Ajilaca/hd2026-T11-J5/docs/img/README.md

# docs/img

Gambar yang dipakai dokumen.

| Berkas | Isi |
|---|---|
| `arsitektur.png` | Diagram alur audio ke skor risiko, diturunkan dari `target/kv260/axi/rtl/suaratb_axil_top.sv`; dipakai di `README.md` |
