Ajilaca/hd2026-T11-J5/docs/vault/keputusan.md

# Keputusan Fase 0

Format: ID, keputusan, alasan, alternatif/risiko. Semua angka berasal dari `python -m golden.analysis.calibrate`
(hasil mentah: `golden/out/phase0_calibration.json`, di .gitignore) dan `pytest golden`.
**Seluruh kalibrasi memakai audio SINTETIS** (`golden/gen/synth.py`); dataset Kaggle belum ada di `data/raw`.

## K-01 Aritmetika
Pembulatan = tambah setengah lalu geser aritmetik (floor(v + 0,5)); saturasi eksplisit; int64 di numpy.
Alasan: cocok dengan penambah + pemotongan bit di RTL, tak memerlukan "round-to-even".

## K-02 Butterfly FFT
Satu pembulatan per butterfly: `(a·2^15 ± b·w + 2^(14+s)) >> (15+s)`. Twiddle k=0 = 32767 (1,0 tak terwakili di Q1.15).
Alasan: satu penambah lebar, galat lebih kecil daripada pembulatan ganda. Plateau SNR ~85 dB pada sinyal keras
dibatasi twiddle Q1.15, bukan lebar data (tabel di `kalibrasi-fase0.md`).

## K-03 Segmen 50 frame
Spesifikasi awal menyebut "segmen 40x50" dan "45 frame setelah onset". Ditafsirkan 5 frame pre-roll + 45 pasca-onset = 50.
50 frame membutuhkan 8240 sampel (0,515 s); klip dataset 8000 sampel diberi 240 nol di ekor.
Risiko: tafsiran ini asumsi; jika bukan itu maksudnya, ubah `PRE_ROLL`/`POST_ONSET`/`N_FRAMES` (CNN mengikuti).

## K-04 Lebar FFT = 24 bit, skala 1/2 di semua stage  *(mengubah nilai awal 18)*
Aturan yang ditetapkan: lebar terkecil dengan galat fitur log-mel ≤ 0,5 langkah int8 (0,0625 oktaf) pada
semua tingkat derau latar uji (σ = 1,5 sampai 100 LSB), dihitung pada elemen ≥ lantai derau kuantisasi
masukan + 10 dB, dengan jadwal skala yang dijamin tanpa overflow. Hasil (RMS galat, oktaf):

| W | σ=1,5 | σ=3 | σ=10 | σ=30 | σ=100 | SNR FFT σ=3 |
|---|---|---|---|---|---|---|
| 18 | 3,42 | 2,94 | 2,20 | 1,08 | 0,27 | -1,5 dB |
| 22 | 0,125 | 0,116 | 0,085 | 0,039 | 0,013 | 21,7 dB |
| 23 | 0,065 | 0,058 | 0,044 | 0,020 | 0,006 | 27,7 dB |
| **24** | **0,033** | **0,030** | 0,023 | 0,010 | 0,004 | **33,8 dB** |

18 bit gagal telak pada ruang tenang. 23 bit nyaris lolos (gagal di σ=1,5) dan lebar ganjil tak menguntungkan.
24 bit tetap muat satu blok DSP (data 24 bit pada port 25 bit, twiddle 16 bit pada port 18 bit).
Prinsip: derau pembulatan FFT (~0,58 LSB absolut) harus jauh di bawah derau kuantisasi int16 masukan;
pada G=8 selisihnya ~10 dB (menambah ~0,4 dB), pada G=2 (W=18) derau FFT justru lebih besar.
Alternatif yang dicatat: jadwal tanpa skala di 1-3 stage pertama menambah ~6 dB SNR per stage
(W=24: 34,3 -> 40,3 -> 46,3 -> 52,5 dB pada σ=3) tetapi kehilangan jaminan overflow: `first3_0` jenuh
(12 sampel) pada batuk ~-10 dBFS, `first1_0` tidak jenuh pada uji tetapi jaminannya hanya untuk puncak < -6 dBFS.
Dipilih jadwal aman. **Terbuka:** apakah pengguna mau `first1_0` (+6 dB) dengan jaminan lebih lemah.
Catatan: AUROC belum dapat diukur (tidak ada data berlabel), sehingga syarat "AUROC turun ≤ 0,01" BELUM diperiksa.

## K-05 Log2: masukan 58 bit, keluaran Q6.8 (spesifikasi awal: 32 bit, Q5.8)  *(mengubah spesifikasi)*
Dengan W=24 dan penguatan 2^(2G)=2^16, batas atas akumulator mel (Parseval, sinyal skala penuh) = 58 bit.
Memotongnya ke 32 bit memerlukan MEL_SHIFT yang bergantung data (13 bit pada ensemble sintetis) dan menyaturasi
bila gain mikrofon berubah. Leading-one 58 bit + keluaran 14 bit hanya menambah beberapa gerbang dan
menghilangkan satu konstanta yang bergantung data. MEL_SHIFT = 0 dipertahankan sebagai tuas bila nanti ingin dikecilkan.
Akurasi log2: ≤ 2 LSB Q.8 (0,008 oktaf) diuji `test_log2_accuracy`.

## K-06 Kuantisasi fitur ⚠
q = sat8(round((L - 6690) / 32)): langkah 0,125 oktaf (0,38 dB); rentang ±16 oktaf (±48 dB) di sekitar offset.
Ensemble sintetis: persentil 0,5/99,5 = 3380/9999 (L, Q6.8), 0,01% elemen nol. `FEAT_OFFSET` hanya berlaku
untuk gain mikrofon sintetis; HARUS dihitung ulang pada audio INMP441 nyata.

## K-07 Detektor batuk ⚠
Nilai awal 8 (rasio) dan 64 (EMA = 2^6), ≥ 2 frame dipertahankan. Sapuan K∈{4,6,8,12,16} x S∈{4..7} x min-hop∈{2,3}
pada aliran sintetis, aturan (ditetapkan sebelum melihat hasil): FP ≤ 0,5/menit (derau, klik, lompatan level;
nada keras dilaporkan terpisah), recall maksimum pada SNR 10 dB, lalu terdekat dengan nilai awal.
Hasil: **K=8, S=6, min-hop=2** (K=4/6 juga 100% pada 10 dB dan lebih tinggi pada 6 dB dengan FP sama, tetapi
lebih jauh dari nilai awal dan negatif sintetis tidak mewakili latar nyata; recall 100%
pada 10/15/25 dB, 61% pada 6 dB; FP derau 0, klik 0; lompatan level x4 memicu 1x per lompatan; nada keras 4,7/menit
tak dapat ditolak detektor energi, begitu pula bicara, dan diserahkan ke CNN).
Tafsiran "tahan 300 ms" = refractory 30 frame setelah segmen selesai. N dibekukan saat merekam; lantai N = 640 (derau ~2 LSB, asumsi).
Risiko: seluruh angka bergantung pada generator sintetis; tidak boleh dikutip sebagai kinerja detektor.

## K-08 Pre-emphasis tanpa pembulatan int16  *(menambah spesifikasi)*
Keluaran pre-emphasis 16+8 bit (bit pecahan = guard FFT). Diukur pada W=24, RMS galat fitur vs float
(6 klip batuk sintetis, 20 dB, elemen ≥ lantai derau masukan + 10 dB; oktaf):

| σ derau latar | pembulatan int16 | 16+8 bit |
|---|---|---|
| 1,5 | 0,066 | 0,029 |
| 3 | 0,064 | 0,027 |
| 10 | 0,120 | 0,024 |
| 30 | 0,044 | 0,011 |

Dengan int16 galat melewati ambang 0,0625 oktaf (K-04) pada σ ≥ 3; dengan 16+8 bit di bawahnya semua.
Biaya: window memakai operan 24 bit x 16 bit (1 DSP). Detektor memakai bagian bulat (pembulatan ke int16)
agar skalanya tak bergantung lebar FFT.

## K-09 CNN
Padding "same" nol; MaxPool lantai (25 -> 12, 12 -> 6): peta akhir 5x6, sesuai hitungan 3.698.448 MAC pada spesifikasi awal.
ReLU+saturasi [0,127] digabung dengan requant (aktivasi tersembunyi non-negatif). Logit akhir int16 (agar tidak
kehilangan resolusi untuk rata-rata 3-5 batuk). GAP lewat pengali resiprokal Q15. Bias int32 yang harus muat 24 bit.

## K-10 Akumulator 24 bit cukup
Fan-in terbesar 288 (conv3). |acc| ≤ 288·127·128 = 4.681.728 tanpa bias; batas 2^23 = 8.388.608; sisa untuk bias ≈ 3,7 juta.
Diuji analitik dan dengan masukan ekstrem (bobot semua -128). `AccOverflow` dilempar bila bias melanggar.

## K-11 Mel
HTK (2595·log10(1+f/700)), segitiga puncak 1 di domain Hz tiap bin, bobot Q0.12 (puncak dipotong 4095).
Tidak ada band kosong; tiap bin masuk ≤ 2 band; ROM sparse 493 kata x 19 bit {band, w, eob}.

## K-12 Anggaran
`budget.py` menghitung bit logis, blok per memori, pengali per fungsi (pemecahan operan DSP), dan siklus ideal.
Hasil P=16: 282 Kbit, 31 blok pengali, 231.168 siklus. EP4CE6 TIDAK muat konfigurasi dasar (memori 105%, pengali 41 vs 15).
Dengan kanal 8/16/16 memori muat (56%) tetapi pengali masih di atas 15 blok keras; perlu pengali di LUT.
Kapasitas perangkat dari ingatan, belum diverifikasi.

## Perubahan terhadap spesifikasi awal
| Item | Awal | Sekarang |
|---|---|---|
| Lebar FFT | 18 (24 bila SNR kurang) | 24 (K-04) |
| log2 | Q5.8, masukan 32 bit | Q6.8, masukan 58 bit (K-05) |
| Pre-emphasis | tak tentu | 16+8 bit (K-08) |
| Detektor 8 / 64 | tebakan | dipertahankan, berbasis sintetis (K-07) |

## K-13 Fase 2: antarmuka front-end (ditulis; tes unit lulus 2026-10-11, lihat K-19)
- `i2s_rx`: FPGA sebagai master (BCLK = clk/96, WS = BCLK/64). 24 bit MSB-first, tertunda 1 BCLK; keluaran = 16 bit teratas
  (pemotongan/lantai). Konsekuensi: derau kuantisasi masukan = int16 seperti diasumsikan golden; bit rendah mikrofon (24 bit)
  tidak dipakai (lihat butir terbuka di status-fase.md).
- `preemph`: SATU perkalian a·x[n-1] menghasilkan dua keluaran: `out_wide` (16+8 bit, jalur FFT, K-08) dan `out_s16`
  (int16, jalur detektor). Keduanya sama persis dengan golden `preemph(x, frac=8)` dan `preemph(x)`. Pembulatan ganda
  TIDAK diganti dengan pembulatan `out_wide` ke 16 bit karena hasilnya bisa berbeda 1 LSB.
- `frame_buf`: cincin 512 x 24 bit; frame diputar ulang 400 sampel/siklus-tunggal setelah sampel pemicu; energi hop
  dihitung di jendela [160f+240, 160f+400) = akhir frame f (golden `hop_energy`). Kontrak: jarak sampel >= 404 siklus.
- `cough_det`: antarmuka event (`trig`, `onset_frame`, `start_frame`, `end_frame`, `seg_done`); nilai pembekuan N saat merekam
  dan refractory identik golden. `seg_done` memberi tahu feat_buf (Fase 3) bahwa 50 kolom terakhir = segmen.

## K-14 FEAT_OFFSET dari audio nyata (6690 -> 8265)
Dihitung oleh `golden.analysis.calibrate_real` pada 1.764 klip batuk nyata (perekam). Dengan 6690 (sintetis) 2,0% elemen jenuh
int8, dengan 8265 0,2%. Model CNN Fase M dilatih pada fitur dengan offset ini, sehingga `params.py`, tabel, paket SV,
dan vektor ikut diubah. PROVISIONAL: gain mikrofon INMP441 berbeda; harus dihitung ulang pada audio perangkat.
FFT_W tetap 24 (pada data nyata W=22 juga lolos ambang K-04, 0,029 oktaf; belum diputuskan).

## K-15 Sumber data tambahan: TBscreen, bukan CODA (2026-10-11)
- CODA TB DREAM tidak dipakai: akses Synapse butuh akun Certified + Validated, Intended Data Use Statement (≤ 500 kata),
  dan persetujuan Terms of Use (Huddart dkk., Sci. Data 2024). Pengguna sudah mencoba; verifikasinya terlalu rumit untuk
  selesai sebelum Demo Day. Set latih "solicited" hanya 0,43 GB (1.105 peserta, 297 positif), jadi bila akses diperoleh
  kelak unduhannya cepat.
- Kriteria data tambahan: unduhan terbuka tanpa persetujuan, label TB per peserta, audio batuk WAV yang bisa di-resample
  ke 16 kHz, dan lisensi yang jelas.
- Terpilih: **TBscreen** (Sharma dkk., Sci. Adv. 2024; Nairobi; CC BY 4.0). Hanya WAV + CSV yang diambil (1,37 GB) dari
  zip 424,6 GB lewat HTTP range request. Klip 1 detik (batuk pasif dan paksa), tiga perangkat (Pixel, mik boundary, Yeti).
- Batas: populasi, perangkat, dan protokol berbeda dari Zambia. Makalah lintas-dataset (Zhang dkk., arXiv 2608.25846)
  melaporkan AUROC lintas-dataset sering < 0,6, jadi TBscreen dipakai untuk (a) evaluasi dalam-dataset kedua dan
  (b) uji lintas-dataset yang jujur, bukan untuk klaim generalisasi.
- Kandidat lain yang diperiksa: COUGHVID/Coswara (terbuka, tetapi COVID, tanpa label TB); halaman MakBRC Uganda
  sedang offline. Tidak ada dataset TB terbuka lain yang ditemukan.

## K-16 Hasil langkah 1-3: tidak ada sinyal audio-TB yang andal; distilasi dibatalkan (2026-10-11)
- TBscreen (`model.md` bagian 5): dalam-dataset 0,577 (nol p95 0,627); lintas-dataset 0,50-0,55; cohort A/C hampir = label
  (cohort saja 0,917), jadi angka dalam-TBscreen tidak dapat ditafsirkan sebagai penanda TB.
- Klinis diperluas (`model.md` bagian 4): 0,743 vs 0,730 (Δ +0,012, CI mencakup 0); fusi terbaik 0,768; target 0,80 belum tercapai.
- VGGish (`model.md` bagian 5): lebih buruk daripada log-mel di Zambia; distilasi tidak dilakukan.
- Dampak: target batuk-saja 0,70 dan fusi 0,80 tidak dicapai dan tidak diklaim. Klaim proyek tetap: pipeline lengkap dengan
  latensi/sumber daya terukur. Opsi revisi target (laporan CI + p-permutasi setelah kontrol sex/usia) menunggu keputusan pengguna.

## K-17 Arsitektur Fase 4: CNN output-stationary, paralel di kanal keluaran (2026-10-11)
- P lane = P kanal keluaran untuk piksel yang sama; 1 aktivasi/siklus dibroadcast; bobot P x 8 bit per
  siklus dari ROM; akumulator 24 bit; MaxPool pada akumulator sebelum requant (bit-exact dengan golden karena M0 >= 0 dan
  ReLU monoton); satu unit requant dipakai bergiliran; FC memakai pe_array yang sama (k=1); GAP unit kecil; padding lewat
  flag luar-batas; deskriptor layer dari ROM `.mem` sehingga model dapat diganti tanpa mengubah RTL.
- Alasan: 1 baca aktivasi/siklus (tanpa RAM berbank/line buffer), siklus = 231.168 pada P=16 (sesuai budget.py), risiko
  jadwal rendah. Ditolak: systolic/weight-stationary (kontrol rumit), paralel-piksel (butuh P aktivasi/siklus),
  akumulator + LR (bukan akselerator; hanya disebut sebagai alternatif hemat di proposal).
- Akurasi TIDAK diklaim (K-16); arsitektur dipilih demi demo akselerator yang terukur.

## K-18 Fase 3: antarmuka dan jadwal DSP (ditulis; tes unit lulus 2026-10-11, lihat K-19)
- Rantai: `frame_buf` -> `window` -> `fft512` -> `power` -> `mel` -> `log_q` -> `quant` -> `feat_buf` (`dsp_chain` membungkus
  window..quant). Semua parameter dari `suaratb_pkg`; ROM dari `rtl/mem/*.mem` (parameter `INIT_*`).
- Laju: waktu per frame tersedia 983 rb siklus (hop 160 sampel @ 98,304 MHz), kebutuhan ~6-8 rb siklus, jadi seluruh rantai
  dibuat SERIAL dan kecil: `fft512` 1 butterfly, 2 siklus/butterfly, RAM in-place 512 x 48 bit; jeda `DRAIN`=8 antar-stage
  (aman; urutan indeks sudah cukup, margin sengaja); keluaran bin tiap `OUT_GAP`=4 siklus (kontrak: `power` >= 1, `mel` >= 3).
- Perkiraan sumber daya (ESTIMASI, bukan laporan alat): pengali window 1, fft 4 (24x16), power 2 (24x24), mel 1 (48x12);
  RAM FFT 24 Kbit, RAM fitur 20 Kbit, akumulator mel 40 x 58 bit di register.
- Verifikasi tanpa simulasi RTL (aturan 3): model Python jadwal FFT (`golden/tests/test_fft_schedule.py`: bit-exact vs golden,
  waktu tulis a'/b', pengalamatan in-place, indeks twiddle, geser stage) dan model alamat window/mel/feat_buf
  (`golden/tests/test_dsp_addressing.py`). Testbench cocotb ditulis (`tb/dsp/test_{window,fft512,power,mel,log_q,quant,dsp_chain,
  feat_buf}.py`) dan baru dijalankan di Fase T. RTL belum di-lint.
  Pembaruan (K-19): tes unit modul dijalankan 2026-10-11 dan lulus; ini verifikasi per modul, bukan regresi terpadu.

## K-19 Aturan 3 diubah: tes unit per modul segera dijalankan (2026-10-11)
- Alasan: kode Fase 2-3 (~20 modul) belum pernah dijalankan; menunda ke Fase T menumpuk bug ke 17-19 Okt, dua hari sebelum
  Demo Day. Pengguna memilih menjalankan tes sekarang.
- Aturan baru: tiap modul Fase 1-5 ditulis bersama tb, lalu langsung dites sendiri (`make test-unit M=<modul>`) dan diperbaiki
  sampai hijau. Fase T tinggal integrasi dan regresi. Lint boleh kapan saja. Commit tetap ditunda sampai selesai dan
  dipecah per branch (fase1-2, fase3, fase4, fase5-6); Fase 5, T, 6 atas nama Faza Dzil.
- Simulator: Verilator 5.020 (apt) terlalu lama untuk cocotb 2.1 (`VerilatedVpi::clearEvalNeeded` tidak ada); tes unit memakai
  **Icarus 12** (`SIM=icarus`, default Makefile). `sva_stream.sv` (properti SVA) dilewati pada Icarus. Parameter string `.mem` dibuat
  tak bertipe (`parameter INIT_FILE = "..."`) karena Icarus 12 gagal mengikat `parameter string`; jalur `.mem` relatif terhadap ROOT.
- Hasil tes unit pertama (2026-10-11): quant, log_q, power, window, mel, fft512, feat_buf, dsp_chain, preemph, i2s_rx,
  frame_buf, cough_det semuanya LULUS bit-exact terhadap vektor golden. Dua perbaikan hanya di sisi tes (model mikrofon I2S tidak
  memulai slot kiri pertama; indeks di tes log_q/quant melebihi 6 bit). Lint Verilator: tanpa galat, hanya peringatan lebar/tak-terpakai.

## K-20 Fase 4: CNN output-stationary ditulis dan lulus tes unit (2026-10-11)
- Modul: `rtl/cnn/{cnn_cfg_pkg,pe_array,requant,gap,cnn_ctrl,cnn_top}.sv`. Bentuk layer/alamat ROM dari
  `golden/gen/gen_cnn_rom.py` (sumber tunggal `params.layer_descs()`, P dari params); ROM dikemas P lane (`cnn_wrom/bias/rq.mem`).
- Pool pada akumulator sebelum requant (bit-exact dengan golden); satu unit requant berurutan; GAP unit sendiri; FC memakai
  pe_array yang sama; deskriptor sebagai fungsi paket (bukan array parameter, kompatibel Icarus).
- HASIL SIMULASI (Icarus, bukan laporan alat): logit cnn_top == golden bit-exact untuk 5 kasus sintetis (bobot acak),
  8 klip dengan bobot terlatih model_v2, dan P = 8 / 16 / 32.
- Siklus inferensi terukur di simulasi (tanpa pemuatan 2.000 siklus): P=8: 451.851; P=16: 226.490; P=32: 122.843.
  Waktu @98,304 MHz = siklus x 10,17 ns -> P=16: ~2,30 ms (BERGANTUNG Fmax; Fmax belum diukur, Fase 6).
- Catatan: sebagian besar tidak dioptimalkan (tulis requant tidak tumpang-tindih dengan MAC), sumber daya belum diukur.

## K-21 Target akurasi diganti pelaporan terukur + pembanding WHO TPP (2026-10-11)
- Alasan: 0,70 (batuk saja) dan 0,80 (fusi) adalah tebakan awal pada spesifikasi awal, bukan syarat lomba atau standar medis. Hasil
  terukur: audio 0,52-0,63 (tidak beda dari nol permutasi); klinis 14 fitur 0,772 pada 1.828 peserta (205 positif); tambahan audio
  di atas klinis +0,003 (CI -0,021..+0,026) pada 360 peserta berlaudio; lintas-perangkat dan lintas-dataset 0,50-0,63.
- Standar pembanding: WHO TPP triase komunitas (sens >= 90%, spes >= 70%). Skor klinis kita: spes 38% pada sens 90%, sens 71% pada
  spes 70%; butuh AUROC ~0,90 (aproksimasi binormal). TIDAK dipenuhi dan tidak diklaim.
- Aturan baru: akurasi dilaporkan sebagai AUROC + CI 95% bootstrap atas peserta + nol permutasi + kontrol jenis kelamin/usia +
  hasil lintas-dataset/perangkat; setiap klaim melewati 0,5 harus menyebut apakah CI mencakup 0,5 atau nol permutasi.
  Target 0,70/0,80 dihapus sebagai syarat lulus. Penurunan kuantisasi <= 0,02 dan HW vs golden bit-exact tetap.
- Posisi alat: prioritas rujukan, bukan pengganti tes. Penguatan data (mis. CODA, K-15) = pasca-hackathon.

## K-22 Clock inti 147,456 MHz untuk versi 150 MHz (2026-10-11)
- Alasan: RTL `optimized` memenuhi timing 6,667 ns (150 MHz) di Vivado XC7A35T-1 untuk P = 8/16/32 (WNS +0,111 / +0,222 / +0,023 ns).
  Clock inti yang dipakai di `target/` = 147,456 MHz = 144 x 1,024 MHz, sehingga BCLK I2S = clk/144 = 1,024 MHz dan fs tepat 16 kHz.
- UART 115200 baud: CLK_PER_BIT = 147,456 MHz / 115200 = 1280 clk/bit (nilai pas). Menggantikan 98,304 MHz / 96 / 853 pada rencana awal.
- Default parameter `suaratb_top` (CLK_PER_BCLK=96, CLK_PER_BIT=853) belum diubah; nilai K-22 diberikan lewat parameter dari `target/`.
- Batas: baru hasil Vivado OOC (tanpa I/O dan MMCM); tidak ada klaim jalan di papan.

## K-23 Embedding pralatih: hasil, kriteria distilasi, dan distilasi dicoba (2026-10-12)
- Uji: HeAR, OPERA-CE, OPERA-CT + LR linear pada 364 peserta (60 positif) dengan protokol tetap (AUROC strat. jenis kelamin, nol
  permutasi dalam klinik x jenis kelamin, statistik maksimum atas tiga kandidat). Angka lengkap: `model.md` §5d.
- Kriteria distilasi ditetapkan sebelum angka final (docstring `model/evaluation/permtest.py`): (1) p label disesuaikan < 0,01; (2) p Δ < 0,05
  DAN batas bawah CI bootstrap Δ > 0; (3) leave-one-clinic-out tidak di bawah p95 nol di kedua arah.
- Hasil: (1) lolos untuk HeAR (0,002) dan OPERA-CT (0,006); (2) gagal untuk semuanya (p Δ 0,003-0,023 tetapi CI mencakup 0);
  (3) gagal (hasil berbeda antar arah). Kontrol negatif (fitur acak) bersih.
- Keputusan awal: menurut kriteria praregistrasi distilasi tidak dibenarkan sebagai klaim. **Distilasi tetap DICOBA sebagai percobaan
  eksploratori** (permintaan pengguna, untuk mengetahui apa yang terjadi), terpisah dari kriteria di atas dan tidak mengubah klaim.
- Hasil distilasi HeAR -> CNN golden (arsitektur hardware: Conv16/32/32, GAP, FC32->16, kepala pelatihan 16->32 komponen PCA; tanpa
  label TB pada distilasi; per lipatan protokol E0; probe LR di dalam lipatan; 364 peserta, 60 positif, 2 ulangan):
  murid 0,654 (nol p95 0,580, p 0,005) vs guru 0,672 pada klip yang sama; jaringan acak 0,598; target teracak 0,529; `model_v2`
  supervised ~0,56. Fidelitas komponen PCA rendah (R2 0,16). Δ di atas klinis +0,015 (tidak signifikan). Jalan pintas: murid
  memprediksi jenis kelamin 0,867 (guru 0,953) dan klinik Kan 0,655 (guru 0,896); AUROC dalam Kan 0,735.
- Keputusan model hardware: murid distilasi adalah KANDIDAT bobot eksploratori menggantikan `model_v2` (arsitektur sama, tanpa
  perubahan RTL). Kuantisasi int8 lulus (penurunan AUROC 0,008 <= 0,02) dan `cnn_top` bit-exact terhadap golden pada 8 klip nyata
  (`model.md` §5e). Bobot murid dapat dipakai pada demo dengan label "eksploratori"; `test_top` dengan bobot ini lulus (dataset dan mikrofon, Icarus); sintesis ulang belum dijalankan.
- Pengamatan boleh dilaporkan: sinyal audio di atas nol permutasi dalam jenis kelamin dengan HeAR/OPERA-CT, tambahan kecil di atas
  gejala klinis (Δ +0,02..+0,04), tahan lintas-mikrofon, tetapi belum presisi, belum konsisten lintas klinik, tanpa data independen.
- Batas: satu populasi, 364 peserta, tanpa data independen; tidak ada klaim klinis dari murid.
- Penguatan: lebih banyak peserta (CODA, K-15) dan validasi pada klinik/populasi lain, pasca-hackathon.

## K-24 Target KV260: clock inti 300,032 MHz (2026-10-18)
- Target demo: Kria KV260 (XCK26-SFVC784-2LV-C), kode di `target/kv260/` (RTL dan golden tidak berubah). K-22 (147,456 MHz) tetap berlaku untuk Artix-7.
- Clock inti dipilih 300,032 MHz = 293 x 1,024 MHz, sehingga `CLK_PER_BCLK = 293` (BCLK I2S 1,024 MHz tepat di nominal) dan `CLK_PER_BIT = 2604`.
- Dasar: pencarian Fmax build `full` (MMCM, I/O, XDC; Vivado 2026.1, satu seed). Pada 300,032 MHz P=16 WNS +0,065 ns dan P=32 +0,219 ns; pada 333,82 MHz P=16 gagal (-0,270 ns), P=32 lolos tipis (+0,018 ns). Aturan pengguna: bila 300 MHz lolos, ambil itu.
- Batas: MMCM dari `pl_clk0` (99,999 MHz) menghasilkan 299,997 MHz (-0,012%), bukan 300,032; fs aktual sekitar 15,998 kHz. Hasil adalah timing Vivado, bukan uji di papan.

## K-25 Gabungan Zambia + TBscreen untuk sinyal audio: aturan ditetapkan sebelum angka (2026-10-21)
- Keputusan pengguna: TBscreen digabung ke pelatihan untuk mencoba menaikkan AUROC. Aturan di bawah ditulis SEBELUM eksperimen
  dijalankan dan tidak diubah setelah angka keluar. Kode: `model/pretrained/merge_tbs.py`.
- Data: Zambia = semesta protokol E0 (peserta berlabel dengan audio) dengan embedding HeAR yang sudah ada (`emb_hear.npz`).
  TBscreen = batuk pasif berlabel TB/NTB dengan WAV, satu perangkat per subjek (urutan pixel, codec, yeti), maksimal 6 klip
  paling keras (tanpa label), resep HeAR sama dengan Zambia (jendela 2 s mulai 0,25 s sebelum onset; klip TBscreen 1 s diberi nol).
  Embedding dirata-rata per peserta. Kolom TBscreen `cohort`, `class`, hasil lab, CXR, penyebab dan pengobatan batuk tidak dipakai.
- Pembanding (dua lengan, lipatan dan pengklasifikasi sama, LR `clinical.lr`):
  Z = latih Zambia saja; G = latih Zambia + TBscreen dengan bobot sampel sehingga tiap sel dataset x label berbobot total sama
  (asal dataset tidak berkorelasi dengan label di distribusi latih). Lipatan Zambia = E0 (5 x 10); TBscreen 5 lipatan per ulangan,
  stratifikasi label x cohort. Uji hanya pada lipatan yang ditahan.
- Ukuran utama: AUROC terstratifikasi jenis kelamin pada peserta Zambia yang ditahan, G vs Z. **Berhasil** bila batas bawah CI 95%
  bootstrap berpasangan (atas peserta Zambia) untuk Δ = G - Z di atas 0 DAN AUROC G di atas p95 nol permutasi (label diacak di dalam
  dataset x klinik/cohort x jenis kelamin, seluruh pipeline diulang). Angka bantu "sekitar 0,07" yang dipakai saat diskusi adalah
  lebar CI satu AUROC dengan 60 positif; kriteria formal memakai CI selisih berpasangan.
- Pelaporan wajib (semua, apa pun hasilnya): Z dan G (mentah dan strat.), Δ dengan CI, nol permutasi; AUROC gabungan
  (Zambia + TBscreen) selalu berdampingan dengan AUROC "asal dataset saja" pada peserta yang sama (sekitar 0,74 dari hitungan
  jumlah peserta); AUROC dalam TBscreen dengan catatan cohort (cohort saja sekitar 0,92); lintas arah TBscreen -> Zambia dan
  Zambia -> TBscreen; uji jalan pintas embedding -> asal dataset.
- Bila berhasil: lanjut ke distilasi CNN hardware dengan klip TBscreen ditambahkan (tahap tanpa label) dan probe berbobot sama.
  Bila tidak: hasil dilaporkan sebagai negatif; penguatan berikutnya lewat CODA (K-15).
- **Hasil K-25 (2026-10-21; `runs/reports/gabungan-tbscreen.md`; HeAR + LR, Zambia 364/60, TBscreen pasif 123 subjek/87 TB, 5 x 10 lipatan, 40 nol):
  TIDAK BERHASIL.** Pada peserta Zambia yang ditahan: Z (Zambia saja) strat. 0,683 / mentah 0,732; G (gabungan berbobot) strat. 0,673 /
  mentah 0,708; Δ = -0,011, CI 95% [-0,056, +0,037]. Nol lengan G: mean 0,505, p95 0,561, maks 0,604; G di atas p95 tetapi Δ tidak positif.
  Menambah TBscreen tidak menaikkan AUROC di Zambia.
- Pelaporan wajib: AUROC gabungan 0,750 vs asal-dataset-saja 0,743 (selisih 0,007: angka gabungan praktis = jalan pintas); rata-rata
  di dalam tiap dataset 0,689; dalam TBscreen 0,579 (cohort saja 0,917); Zambia -> TBscreen 0,575; embedding -> asal dataset 1,000
  (dataset sepenuhnya dapat dikenali).
- Pengamatan eksploratori (tidak diregistrasi, tanpa nol sendiri): TBscreen -> Zambia 0,701 mentah / 0,644 strat. (HeAR); belum bisa
  dianggap sinyal sebelum ada nol permutasi dan kontrol perancu.
- Keputusan: distilasi CNN dengan klip TBscreen ditambahkan TIDAK dilanjutkan (syarat K-25 tidak terpenuhi). Penguatan berikutnya
  lewat CODA (K-15). Bobot hardware untuk demo tetap murid distilasi K-23.

## K-26 Lanjutan penguatan audio: aturan ditetapkan sebelum angka (2026-10-21)
- Urutan disetujui pengguna: (4) uji TBscreen -> Zambia, (2) guru pralatih lain, (3) gabungan guru, (1) distilasi dengan klip
  tanpa label tambahan. CODA (K-15) dicoba ulang oleh pengguna.
- **(4) TBscreen -> Zambia.** Angka utama SUDAH terlihat di K-25 (HeAR 0,701 mentah / 0,644 strat.), jadi ini uji konfirmasi, bukan
  penemuan. Latih LR (`clinical.lr`) pada 123 subjek TBscreen pasif (embedding HeAR rata-rata per subjek), uji pada 364 peserta
  Zambia. Nol utama: label TBscreen diacak DI DALAM jenis kelamin (memutus kaitan label-cohort), 200 kali, seluruh pelatihan diulang.
  Nol kedua: diacak di dalam cohort x jenis kelamin (dilaporkan, diperkirakan tidak informatif karena cohort ~ label).
  Kontrol: (a) pelatihan berbobot sama per sel jenis kelamin x label; (b) embedding diresidualisasi terhadap jenis kelamin + usia,
  regresi dipasang terpisah per dataset tanpa label; (c) AUROC skor -> jenis kelamin di Zambia.
  **Dianggap sinyal** bila AUROC strat. Zambia > p95 nol utama DAN tetap > p95 nol utama pada kontrol (a) dan (b).
- **(2) Guru lain.** Kandidat ditetapkan sekarang: AST (`MIT/ast-finetuned-audioset-10-10-0.4593`), CLAP (`laion/clap-htsat-unfused`),
  WavLM (`microsoft/wavlm-base-plus`), Whisper encoder (`openai/whisper-base`). Klip dan jendela identik dengan HeAR (2 s, pilihan klip
  sama, seleksi tanpa label). Pooling: AST pooler, CLAP `get_audio_features`, WavLM dan Whisper rata-rata keadaan tersembunyi terakhir.
  Evaluasi protokol E0 (5 x 10, nol 40). Kandidat dianggap lebih baik dari HeAR hanya bila batas bawah CI 95% bootstrap berpasangan
  Δ (kandidat - HeAR, AUROC strat.) > 0. Semua kandidat dilaporkan.
- **(3) Gabungan guru.** Rata-rata skor OOF terstandar HeAR + OPERA-CT, dan HeAR + kandidat terbaik (2). Kriteria sama dengan (2).
- **(1) Distilasi diperluas.** Dijalankan dengan guru terbaik dari (2)/(3). Kriteria ditetapkan sebelum (1) dimulai.
- **Hasil K-26 (4) (2026-10-21; `runs/reports/tbscreen-ke-zambia.md`; HeAR + LR, latih TBscreen 123/87, uji Zambia 364/60, nol 200): BUKAN SINYAL
  menurut kriteria.** AUROC strat. Zambia: utama 0,644 (nol p95 0,624; p 0,035; skor -> jenis kelamin 0,740); (a) berbobot jenis kelamin x label
  0,634 (p95 0,637; p 0,065; gagal tipis); (b) residu jenis kelamin+usia 0,659 (p95 0,633; p 0,020; skor -> jenis kelamin 0,499). Kriteria
  meminta ketiganya lolos; (a) gagal sebesar 0,003. Pembacaan: bukti lemah (60 positif; nol maks 0,69-0,70), tidak ditolak dan tidak
  diklaim; layak diulang dengan data lebih besar (CODA).

## K-27 Pembagian acak 327 Zambia + 110 TBscreen, uji pada sisanya: aturan ditetapkan sebelum angka (2026-10-21)
- Permintaan pengguna: latih dengan 327 peserta ACAK Zambia dan 110 subjek ACAK TBscreen; uji pada sisanya (37 Zambia, 13 TBscreen);
  bandingkan dengan baseline model sekarang. Pembagian tunggal dengan 37 dan 13 uji (8 dan 6 positif pada percobaan awal) terlalu
  derau, jadi pembagian acak DIULANG 500 kali (seed 1000+r, acak sederhana tanpa stratifikasi; pembagian ditolak dan diundi ulang bila
  uji Zambia atau uji TBscreen kehilangan salah satu kelas).
- Model: embedding HeAR + LR (`clinical.lr`), sama dengan K-25/K-26. Murid CNN int8 yang ada di FPGA adalah distilasi dari HeAR
  (CV E0: guru 0,672, murid 0,654 AUROC strat.); murid TIDAK dilatih ulang per pembagian (mahal), jadi HeAR + LR adalah wakil.
- Lengan: Z = latih 327 Zambia saja (baseline model sekarang pada pembagian yang sama); G = 327 Zambia + 110 TBscreen, bobot sel
  dataset x label sama; T = 110 TBscreen saja. Semua diuji pada 37 Zambia dan 13 TBscreen sisa.
- Ukuran utama: skor tiap peserta Zambia dirata-rata atas pembagian tempat ia menjadi uji (~50 kali); AUROC strat. jenis kelamin.
  Δ (G - Z) dengan CI 95% bootstrap berpasangan atas peserta. Berhasil bila batas bawah CI > 0 DAN G > p95 nol.
  Nol: label latih diacak di dalam klinik x jenis kelamin (Zambia) dan cohort x jenis kelamin (TBscreen), 20 nol x 100 pembagian.
- Dilaporkan juga: sebaran AUROC per pembagian (rata-rata, simpangan, persentil 2,5/97,5) untuk Zambia dan TBscreen. AUROC TBscreen
  tercampur cohort (A 93 subjek, C 30 subjek; C seluruhnya NTB) dan hanya dilaporkan dengan catatan itu.
- Batas klaim: ini estimasi untuk HeAR + LR dengan data kecil, bukan kinerja klinis; murid CNN di FPGA tidak diuji ulang.
- **Hasil K-27 (2026-10-21; `runs/reports/split-327-110.md`; HeAR + LR, 500 pembagian acak, nol 20 x 100): TIDAK BERHASIL menurut kriteria.**
  AUROC strat. jenis kelamin pada peserta Zambia uji (skor dirata-rata atas ~51 pengujian per peserta): Z 0,697, G 0,680, T 0,593.
  Δ (G - Z) = -0,017, CI 95% [-0,070, +0,035]. Nol p95: Z 0,633, G 0,659 (maks 0,668); Z di atas p95, G hanya tipis di atasnya.
  Satu pembagian (37 uji Zambia, 13 uji TBscreen) berayun lebar (Zambia strat. lengan Z 0,70 ± 0,12, rentang 0,43-0,94), jadi angka
  dari satu pembagian tidak boleh dipakai. Menambah TBscreen tidak menaikkan AUROC (konsisten dengan K-25).

## K-28 Kurva belajar HeAR + LR: 291 vs 327 peserta latih Zambia, uji peserta yang sama (2026-10-21)
- Pertanyaan pengguna: lebih baik 327 atau 291 peserta latih? Angka yang ada berbeda protokol (K-27 lengan Z 0,697 dengan uji 37; CV E0 0,683 dengan uji 73),
  jadi tidak sebanding. Desain berpasangan: 500 pembagian acak (seed 1000+r); urutan acak peserta; UJI = 37 peserta terakhir (sama untuk semua ukuran);
  latih = n peserta pertama dengan n dalam {100, 150, 220, 291, 327} (himpunan 291 adalah bagian dari 327). HeAR + LR (`clinical.lr`), Zambia saja.
- Ukuran utama: AUROC strat. jenis kelamin pada skor uji dirata-rata per peserta; Δ (327 - 291) dengan CI 95% bootstrap berpasangan atas peserta.
  327 dianggap lebih baik hanya bila batas bawah CI > 0. Pembagian ditolak bila uji kehilangan salah satu kelas.
- Batas klaim: HeAR + LR, bukan murid CNN di FPGA; data kecil (60 positif).
- **Hasil K-28 (2026-10-21; `runs/reports/kurva-belajar.md`; HeAR + LR Zambia saja, 500 pembagian, uji 37 peserta sama): 327 TIDAK terbukti lebih baik dari 291.**
  AUROC strat.: 100 -> 0,700; 150 -> 0,704; 220 -> 0,692; 291 -> 0,703; 327 -> 0,698. Δ (327 - 291) = -0,005, CI 95% [-0,013, +0,004].
  Kurva datar: menambah peserta Zambia dalam kisaran ini tidak menaikkan AUROC (plafon HeAR + LR sekitar 0,70 pada protokol ini).
- **Tambahan K-26 (3) sebelum evaluasi dijalankan (2026-10-21, permintaan pengguna; belum ada angka guru lain yang terlihat):** lengan gabungan
  ketiga = rata-rata skor OOF terstandar SEMUA guru yang tersedia (HeAR, OPERA-CT, Whisper, WavLM, AST, CLAP). Kriteria sama (batas bawah CI 95%
  Δ vs HeAR > 0). Dicatat sebagai salah satu dari tiga gabungan; jumlah perbandingan bertambah, jadi hasil tipis di atas kriteria dibaca hati-hati.
- **Hasil K-26 (2)(3) (2026-10-22; `runs/reports/guru-lain.md`; protokol E0, 364 peserta / 60 positif, 5 x 10 lipatan, nol 40): TIDAK ADA guru atau gabungan
  yang lebih baik dari HeAR menurut kriteria (batas bawah CI 95% Δ > 0).** AUROC strat.: HeAR 0,683; OPERA-CT 0,667; Whisper 0,650; WavLM 0,645; AST 0,637;
  CLAP 0,601 (Δ -0,082, CI [-0,141, -0,025], lebih buruk). Gabungan: HeAR + OPERA-CT 0,714 (Δ +0,031 [-0,009, +0,071]); HeAR + Whisper 0,683 (Δ -0,000);
  semua guru 0,703 (Δ +0,020 [-0,025, +0,067], ditambahkan sebelum angka). Gabungan tampak sedikit lebih tinggi tetapi CI mencakup 0 dan ada tiga
  gabungan yang dicoba, jadi tidak diklaim. Jalur (1) distilasi dari gabungan TIDAK dijalankan (peningkatan belum terbukti). CLAP: keluaran
  `get_audio_features` berubah di transformers baru (objek keluaran; embedding di `pooler_output`), diperbaiki di `teachers.py` sebelum embedding dijalankan.

## K-29 Model demonstrasi batuk vs bicara untuk membuktikan akselerator: aturan ditetapkan sebelum angka (2026-10-22)
- Alasan (saran mentor): model audio TBC lemah dan tidak bisa ditingkatkan lagi dalam waktu tersisa. Untuk menunjukkan akselerator bekerja
  pada tugas dengan sinyal yang jelas, arsitektur yang SAMA (log-mel 40x50, CNN 16/32/32, GAP, FC 32-16-1, int8, 14.496 bobot) dilatih ulang
  untuk tugas biner lain. RTL dan golden tidak diubah; hanya bobot/ROM, dengan bitstream dan aplikasi xmutil terpisah (`suaratb_cough`).
- Tugas: batuk (1) vs bukan batuk (0). Positif: klip batuk Zambia `distill_clips.npz` (6.354 klip, 364 peserta; detektor golden).
  Negatif: Speech Commands v0.02 test set (CC BY 4.0; 4.890 klip: 11 folder kata + `_silence_`), dipotong dengan detektor golden yang sama
  (segmen mulai onset - PRE_ROLL; bila detektor tidak memicu, jendela di sekitar energi puncak).
- Pembagian: 20% peserta Zambia dan 20% pembicara Speech Commands (seed 0) sebagai UJI, tidak pernah dilihat saat latih. Tanpa pemilihan
  model pada data uji (jumlah epoch dan hiperparameter tetap, ditetapkan di skrip sebelum dijalankan).
- Ukuran utama: akurasi dan AUROC int8 golden pada UJI, ambang logit 0; dilaporkan juga sensitivitas, spesifisitas, akurasi per folder kata
  dan `_silence_`. Kriteria kuantisasi seperti K-21: penurunan AUROC float -> int8 <= 0,02. HW harus bit-exact terhadap golden.
- Batas klaim: tugas demonstrasi, BUKAN TBC. Angka ini tidak boleh disebut sebagai kinerja skrining TBC. Batuk berasal dari ponsel/perekam
  Zambia dan bicara dari Speech Commands (perangkat, ruang, dan bahasa berbeda), jadi sebagian pemisahan bisa berasal dari perbedaan sumber;
  kinerja dengan INMP441 di lokasi belum dikalibrasi.
- **Hasil K-29 (2026-10-22; `runs/reports/batuk-vs-bicara.md`; UJI 1.272 batuk dari 20% peserta + 1.063 bukan batuk dari 20% pembicara):**
  int8 golden AUROC 0,9989, akurasi 99,1% pada ambang 0 (batuk terdeteksi 99,4%, bukan batuk ditolak 98,8%; per kata 95,5-100%, `_silence_` 98,6%).
  Float sama (0,9989; 99,1%), penurunan kuantisasi 0,0000 (LULUS). Puncak akumulator 151.669 (< 2^23). Batas klaim tetap seperti di atas:
  sumber batuk dan bicara berbeda, bukan kinerja TBC.

## K-30 Kurva belajar model gejala klinis: apakah lebih banyak data menaikkan AUROC? Aturan ditetapkan sebelum angka (2026-10-22)
- Pertanyaan pengguna: apakah data yang lebih banyak membuat model gejala lebih baik (sebagai pengganti data sintetis, yang tidak bisa membuktikan deteksi TBC)?
- Data: peserta Zambia berlabel `ground_truth_tb` (1.828; 205 positif). Fitur: 14 kolom gejala/anamnesis/antropometri (`fusion.CLIN`; 15 variabel setelah `tobacco_use`).
  Pembanding sekunder: 5 gejala (jenis kelamin, lama batuk, keringat malam, penurunan berat badan, BMI), DIPILIH pada data yang sama, jadi optimistis.
- Model: regresi logistik `fusion.cv_auc` (imputasi median + indikator, standardisasi, C=0,3, class_weight balanced).
- Desain: 50 ulangan (seed 0-49). Tiap ulangan: UJI = 400 peserta acak berstrata label x klinik (tetap untuk semua ukuran dalam ulangan itu); sisa 1.428 = kolam latih.
  Latih pada subset acak berstrata dari kolam dengan ukuran m dalam {200, 400, 800, 1.200, 1.428}. (Menyimpang dari rencana awal sampai 1.828: sisa 400 dipakai untuk UJI tetap.)
- Ukuran utama: AUROC mentah pada UJI, rata-rata dan simpangan atas 50 ulangan, persentil 2,5/97,5. Δ berpasangan (1.428 - 400) dengan persentil 2,5/97,5 atas ulangan.
  Kurva dibaca MASIH NAIK hanya bila batas bawah Δ (1.428 - 400) > 0 dan rata-rata Δ >= 0,01; selain itu dibaca datar.
- Batas klaim: data satu sumber (Zambia); hasil dalam-dataset; jumlah positif di ukuran kecil sedikit (200 peserta sekitar 22 positif); bukan kinerja klinis.
- **Hasil K-30 (2026-10-22; `runs/reports/kurva-belajar-gejala.md`; 50 ulangan, UJI tetap 400 peserta, sekitar 45 positif):** menurut kriteria, kurva DATAR pada 400-1.428 peserta.
  14 kolom: AUROC UJI 200 -> 0,717; 400 -> 0,739; 800 -> 0,752; 1.200 -> 0,761; 1.428 -> 0,765; Δ (1.428 - 400) = +0,026 [-0,014; +0,068] (CI mencakup 0, jadi tidak lolos kriteria "masih naik").
  5 gejala (dipilih pada data yang sama): 0,759 -> 0,767 -> 0,769 -> 0,772 -> 0,772; Δ = +0,006 [-0,011; +0,030]. Pembanding 14 kolom 1.428 - 200: +0,047 [+0,004; +0,104].
  Tafsir: model gejala melandai; sebagian besar kinerjanya sudah ada pada sekitar 400 peserta (lima gejala), dan 14 kolom baru menyusul 5 gejala pada ukuran besar. Data lebih banyak dari sumber yang sama kemungkinan hanya menambah kepastian, bukan akurasi.

## K-31 Simulasi data gejala sintetis 5.000 dan 10.000 peserta (ilustrasi, BUKAN bukti klinis): aturan ditetapkan sebelum angka (2026-10-22)
- Permintaan pengguna: mencoba data sintetis untuk melihat perilaku model gejala bila datanya 5.000 dan 10.000. Hasil ini hanya ilustrasi metode.
- Generator: regresi logistik 14 kolom (tanpa class_weight, C=0,3) dilatih pada 1.828 peserta Zambia berlabel. Peserta sintetis = baris fitur dari data asli
  diambil acak dengan pengembalian; label ~ Bernoulli(p dari generator). Karena label dibuat dari generator, AUROC maksimum yang mungkin dicapai model adalah AUROC generator itu
  sendiri (batas atas, dihitung pada 200.000 baris sintetis). Hasil melingkar: menunjukkan seberapa cepat penaksir mendekati batas atas, bukan bahwa gejala mendeteksi TBC.
- Kontrol label acak: label ~ Bernoulli(prevalensi 11,2%) tidak bergantung pada fitur. Harapan: AUROC sekitar 0,5 pada semua ukuran.
- Model yang diuji: pipeline sama seperti K-30 (imputasi, standardisasi, LR C=0,3 class_weight balanced). Ukuran latih {400, 1.428, 5.000, 10.000}, 30 ulangan,
  tiap ulangan membangkitkan data latih baru dan UJI sintetis 20.000 baris dari generator yang sama.
- Batas klaim: semua angka berlabel SIMULASI. Tidak boleh dikutip sebagai kinerja deteksi TBC, tidak boleh dicampur dengan hasil data asli, dan tidak masuk materi klaim.
- **Hasil K-31 (2026-10-22; `runs/reports/simulasi-gejala.md`; SIMULASI, 30 ulangan, UJI sintetis 20.000):** batas atas AUROC generator 0,795.
  AUROC UJI: 400 -> 0,757; 1.428 -> 0,782; 5.000 -> 0,791; 10.000 -> 0,792 (jarak ke batas atas +0,038; +0,013; +0,004; +0,003). Kontrol label acak 0,499-0,501 pada semua ukuran.
  Tafsir: bila dunia nyata persis seperti generator, ukuran 5.000 sudah hampir di batas atas dan 10.000 tidak menambah; kontrol acak membuktikan label tak berhubungan tidak dipelajari. Bukan bukti deteksi TBC.

## K-32 Lebih banyak batuk per peserta (lintas perangkat, semua klip) dan titik kerja: aturan ditetapkan sebelum angka (2026-10-22)
- Model: murid CNN int8 distilasi (`runs/model_distill/qmodel.npz`, sama dengan ROM bitstream `suaratb_axil`); logit golden per klip dari `processed/clips/<perangkat>`.
- Peserta: 349 peserta berlaudio ponsel C (58 positif), sama dengan `fit_fusi.py`. Skor audio peserta = rata-rata logit klipnya.
- Varian (1): A = ponsel C, 10 klip pertama (acuan; paket sekarang); B = ponsel C, semua klip; C = ponsel A+B+C, 10 klip pertama tiap ponsel;
  D = ponsel A+B+C, semua klip; E = D + perekam (semua klip). Perangkat yang tidak ada untuk peserta tertentu dilewati.
- Ukuran utama: AUROC audio mentah per varian; Δ berpasangan (varian - A) dengan CI 95% bootstrap atas peserta (2.000). Varian dianggap LEBIH BAIK hanya bila batas
  bawah CI > 0. Sekunder: AUROC fusi (skor gejala dari peserta tanpa audio + LR [gejala, audio] out-of-fold 5 lipatan, seperti `fit_fusi.py`).
  Lima varian dibandingkan, jadi hasil tipis di atas kriteria dibaca hati-hati.
- (3) Titik kerja: untuk audio A, fusi A, gejala saja, dan varian terbaik: ambang pada sensitivitas 95/90/85/80/70% (persentil skor positif), dilaporkan
  spesifisitas dan jumlah dirujuk per 100 orang pada prevalensi 11,2% (Zambia berlabel). Ambang dipilih pada data yang sama: optimistis.
- Batas klaim: lintas perangkat hanya berlaku untuk mode dataset (axil); alat dengan satu mikrofon tidak bisa memakainya. Bukan kinerja klinis.
- **Hasil K-32 (2026-10-22; `runs/reports/lintas-perangkat.md`; 349 peserta, 58 positif, 15.155 klip):** TIDAK ADA varian yang lebih baik menurut kriteria.
  AUROC audio: A (ponsel C, 10 klip) 0,715; B (ponsel C semua) 0,700 (Δ -0,015 [-0,056; +0,024]); C (A+B+C, 10/ponsel, 30 klip) 0,740 (Δ +0,025 [-0,016; +0,068]);
  D (A+B+C semua) 0,725; E (+perekam) 0,733. Fusi OOF: A 0,798; C 0,807. Gejala saja 0,782.
  Titik kerja fusi A (optimistis): sens 90% -> spes 49% (55 dirujuk/100); sens 80% -> spes 68% (37 dirujuk/100); sens 70% -> spes 74%.
  Tafsir: lebih banyak klip melewati ~10 tidak terbukti menambah; C tampak tertinggi tetapi CI mencakup 0 dan lima varian dicoba. Paket board tetap A.

## K-33 Cara agregasi logit per peserta (rata-rata pintar, buang klip buruk): aturan ditetapkan sebelum angka (2026-10-22)
- Data sama dengan K-32 varian A (ponsel C, 10 klip pertama, 349 peserta, 58 positif; logit golden murid CNN int8).
- Agregasi yang diuji: (a) rata-rata (acuan); (b) median; (c) rata-rata terpangkas 20% (buang 20% logit terendah dan tertinggi);
  (d) rata-rata 50% logit tertinggi; (e) rata-rata setelah membuang klip buruk: klip dengan sampel terpotong (|x| >= 32.000 pada > 0,1% sampel)
  atau RMS terendah 20% di antara klip peserta itu; bila semua terbuang, pakai semua klip.
- Ukuran utama: AUROC audio; Δ (varian - rata-rata) dengan CI 95% bootstrap atas peserta (2.000). LEBIH BAIK hanya bila batas bawah CI > 0.
  Sekunder: AUROC fusi OOF seperti K-32. Empat varian dibandingkan; hasil tipis dibaca hati-hati.
- Varian yang lolos hanya diterapkan ke paket board bila pengguna menyetujui (mengubah axil_batch/axil2/mic1/mic2).
- **Hasil K-33 (2026-10-22; `runs/reports/agregasi-logit.md`; 349 peserta, 3.399 klip, 0,0% klip terpotong):** TIDAK ADA agregasi yang lebih baik menurut kriteria.
  AUROC audio: rata-rata 0,715 (acuan); median 0,708 (Δ -0,007 [-0,044; +0,032]); terpangkas 20% 0,721 (+0,006 [-0,019; +0,033]);
  50% tertinggi 0,749 (+0,034 [-0,016; +0,088]); buang klip buruk (RMS terendah 20%) 0,736 (+0,021 [-0,014; +0,058]). Fusi OOF: acuan 0,798; 50% tertinggi 0,822.
  Tafsir: "50% tertinggi" tampak terbaik tetapi CI mencakup 0 dan empat varian dicoba; tidak diterapkan ke paket. Bisa diuji ulang pada data independen.

## K-34 UART dihapus; AXI4-Lite satu-satunya antarmuka host (2026-10-22)
- Alasan (pengguna): antarmuka host yang dipakai dan terbukti di papan adalah AXI4-Lite; UART tidak dipakai lagi.
- Dihapus: `rtl/sys/` (`uart_rx`, `uart_tx`, `uart_bridge`, `csr`, `suaratb_top`), `tb/sys/test_uart.py`, `tb/sys/test_top.py`, `tb/common/uart_model.py`,
  `sw/host/host.py` (host UART), `target/kv260/uart/` (`kv260_top` dan skrip sintesis versi UART), hasil layout ASIC `uart_bridge` (png, metrics, baris csv, dan entri daftar modul).
- Pengganti: `target/kv260/axi/rtl/suaratb_axil_top.sv` (glue sistem) + `axil_ctrl.v`; uji ujung ke ujung `tb/sys/test_axil.py` (lulus 3, lewati 1 yang memerlukan AXIL_MIC=1).
  `rtl/files.f` tidak lagi memuat `rtl/sys/*`. Skrip Yosys (`target/yosys/synth.sh`) dan sintesis ASIC (`target/asic/synth_sky130.sh`) kini menyintesis `suaratb_axil_top`.
- Tidak berubah: golden/, blok rtl/ lain, tag `submission` (versi UART tetap dapat diperiksa dari tag dan riwayat git). Hasil sintesis/Fmax lama yang berasal dari `suaratb_top` (UART) tetap dalam
  `docs/vault/sintesis.md` sebagai catatan riwayat; angka baru dari top AXI tidak sebanding satu lawan satu. Build bitstream lama (`full_P*`, versi UART) tetap di `/data/suaratb/build/kv260/`.
