Ajilaca/hd2026-T11-J5/docs/result/result.md

# SuaraTB: laporan hasil

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

## 1. Ringkasan

| Pertanyaan | Jawaban | Bukti |
|---|---|---|
| Apakah pipeline audio ke skor jalan di akselerator khusus? | **Ya.** Bit-exact terhadap model numpy (golden) di tiap modul dan ujung ke ujung. Di papan KV260, 968 dari 968 klip (100 peserta) identik dengan golden | §4, §5.3 |
| Muat dan cukup cepat di FPGA? | **Ya.** Artix-7 XC7A35T: 150 MHz terpenuhi untuk P = 8/16/32. KV260: 300 MHz terpenuhi, P = 16 memakai 6.326 LUT (5,4%) | §5 |
| Apakah gejala klinis berguna untuk skrining? | AUROC 0,77 pada 1.828 peserta. **Belum** memenuhi standar WHO TPP | §7.2 |
| Apakah audio batuk mendeteksi TBC? | CNN dari nol: tidak (AUROC sekitar 0,56). Embedding HeAR: ada indikasi sinyal (AUROC 0,71 dalam jenis kelamin, p = 0,002), tetapi tambahannya di atas gejala kecil dan **belum terbukti** | §7.3 sampai 7.5 |
| Bisa dipindah ke hardware? | Sebagian besar. Murid distilasi AUROC 0,654 (guru 0,672), kuantisasi int8 hanya menurunkan 0,008, RTL bit-exact | §7.6 |
| Apakah bisa jadi chip? | `cnn_top` P = 16 pada 10,24 MHz selesai di-layout sky130 dengan kapasitansi, antena, LVS, DRC routing, dan signoff XOR/DRC semuanya 0. Chip utuh dan tape-out belum | §8 |

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

## 2. Sistem

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

## 3. Fase 0: parameter dan kalibrasi

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

## 4. Verifikasi RTL

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

| Cakupan | Hasil |
|---|---|
| Front-end: `i2s_rx`, `preemph`, `frame_buf`, `cough_det` | Lulus |
| DSP: `window`, `fft512`, `power`, `mel`, `log_q`, `quant`, `feat_buf`, `dsp_chain` | Lulus (12 modul Fase 2-3) |
| CNN: `requant`, `gap`, `cnn_top` | Lulus: bobot acak (5 kasus), bobot terlatih (8 klip nyata), P = 8/16/32 |
| Sistem: `suaratb_axil_top` | Mode dataset lewat AXI4-Lite lulus bit-exact (`tb/sys/test_axil.py`: 3 lulus, 1 dilewati karena perlu `AXIL_MIC=1`). Mode mikrofon lulus di simulasi dan berjalan di papan |
| Setelah perbaikan timing (100 MHz) dan pipeline 150 MHz | Semua tes di atas diulang dan lulus |
| Dengan bobot murid distilasi | `cnn_top`, mode mikrofon, dan dataset + mikrofon lulus bit-exact |

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

## 5. Sintesis dan papan

### 5.1 Artix-7 XC7A35T-1 (Vivado, mode OOC, setelah route)

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

\* Estimasi vectorless (keyakinan "Medium"), bukan pengukuran.

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

### 5.2 Kria KV260 (XCK26-SFVC784-2LV-C, Vivado 2026.1)

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

### 5.3 Uji di papan

Yang terukur di papan (P32, sekitar 300 MHz):

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

Latensi untuk 10,24 MHz dan P16 dihitung dari siklus simulasi, bukan diukur di papan.

## 6. Data

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

## 7. Model dan hasil klinis

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

### 7.1 Kuantisasi

| Model | AUROC float | AUROC int8 golden | Selisih | Kriteria <= 0,02 |
|---|---|---|---|---|
| CNN dari nol (`model_v2`) | 0,545 | 0,546 | +0,001 | lulus |
| Murid distilasi HeAR | 0,653 | 0,645 | 0,008 | lulus |

Lulus kuantisasi tidak membuktikan kemampuan klinis. Logit `model_v2` hampir konstan.

### 7.2 Gejala klinis dan standar WHO

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

### 7.3 Audio, CNN dilatih dari nol (360 peserta, 58 positif)

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

### 7.4 Embedding pralatih dengan protokol tetap (364 peserta, 60 positif)

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

### 7.5 Uji permutasi final dan pemeriksaan

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

### 7.6 Distilasi HeAR ke CNN golden (eksploratori)

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

### 7.7 Upaya menguatkan sinyal audio (21-22 Oktober)

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

### 7.8 Model gejala klinis dan simulasi

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

### 7.9 Lintas perangkat dan agregasi (349 peserta, 58 positif, murid CNN di FPGA)

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

### 7.10 Model demonstrasi batuk vs bukan batuk (K-29)

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

## 8. Layout ASIC sky130

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

### 8.1 Keputusan desain

| Aspek | Keputusan | Alasan |
|---|---|---|
| Clock | 10,24 MHz (periode 97,656 ns) | Di 25 ns hold corner SS gagal (-1,78 ns): delay input SDC (20% periode) lebih kecil dari latensi clock SS (8 sampai 12 ns). Di 97,656 ns sebabnya hilang. Clock tidak sepenting itu untuk alat ini |
| Lebar CNN | P = 16 | FPGA yang diuji memakai P = 32; ASIC dibuat lebih kecil |
| Antarmuka host | AXI4-Lite, tanpa UART | Sama dengan yang sudah jalan di papan |
| Memori | 14 makro SRAM OpenRAM 2 KB (6 RAM, 8 ROM bobot) | ROM bobot 116 Kbit yang disintesis sebagai logika membuat global routing macet lebih dari 40 menit |
| Bobot CNN | Dimuat lewat port `wl_*` setelah chip menyala | ROM berupa SRAM, jadi kosong saat start. Perilaku ini beda dari RTL FPGA |

### 8.2 Hasil `cnn_top` P16, 10,24 MHz (run `p16_10m_eco8`)

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

### 8.3 Perjalanan perbaikan kapasitansi dan antena

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

| Putaran | Cara | Kapasitansi | Antena |
|---|---|---|---|
| Dasar | Alur penuh | 147 | 43 |
| 1 | Buffer kapasitansi, GRT ulang, perbaikan antena, jumper met1 | 11 | 38 |
| 2 | Sama | 2 | 17 |
| 3 | Sama | 1 | 31 |
| 4 | Jumper kumulatif (87 net) | 0 | 12 |
| 5 | Dioda tanpa GRT ulang | 2 | 5 |
| 6 | Dioda + buffer pin makro, tanpa GRT ulang | 1 | 3 |
| 7 | Dioda + buffer pin makro, tanpa GRT ulang | 2 | 4 |
| **8** | **Buffer pemecah beban + dioda + jumper, tanpa GRT ulang** | **0** | **0** |

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

### 8.4 Modul lain (13 layout, 40 MHz)

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

### 8.5 Yang belum ada

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

## 9. Keputusan penting

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

## 10. Keterbatasan

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

## 11. Peta jalan

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

## 12. Repositori dan dokumentasi

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

## Lampiran: lokasi bukti

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
