Ajilaca/hd2026-T11-J5/target/asic/results/metrics.csv

layout | run | pin | sel | area_sel_um2 | die_um2 | util | drc_magic | drc_klayout | lvs | xor | route_drc | setup_ws_ns | hold_ws_ns | setup_vio | hold_vio | antena_net | slew_vio | cap_vio | fanout_vio | daya_W | kabel_um
i2s_rx | c1 | 25 | 393 | 3452.06 | 10846.6 | 0.451407 | 0 | 0 | 0 | 0 | 0 | 17.669166185847565 | 0.11245710236889404 | 0 | 0 | 0 | 0 | 0 | 0 | 0.00024004683655221015 | 5635
preemph | c1 | 62 | 2424 | 16550.9 | 59039.7 | 0.32393 | 0 | 0 | 0 | 0 | 0 | 12.500827393732502 | 0.11154294470456354 | 0 | 0 | 0 | 0 | 0 | 10 | 0.002011108910664916 | 33016
gap | c1 | 50 | 1128 | 8389.3 | 29393.8 | 0.349055 | 0 | 0 | 0 | 0 | 0 | 15.01399935762494 | 0.10644802007816193 | 0 | 0 | 0 | 0 | 0 | 5 | 0.0005685029900632799 | 12804
window | c1 | 57 | 4591 | 28065.7 | 106619 | 0.291933 | 0 | 0 | 0 | 0 | 0 | 8.75295061206042 | 0.11090340071314068 | 0 | 0 | 0 | 106 | 0 | 8 | 0.0057122777216136456 | 100555
log_q | c1 | 92 | 1537 | 11283.3 | 36267.2 | 0.372768 | 0 | 0 | 0 | 0 | 0 | 10.429465586360422 | 0.12704193612242828 | 0 | 0 | 0 | 7 | 0 | 3 | 0.0009492959943599999 | 27709
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
