Ajilaca/hd2026-T11-J5/(commit log)

2026-10-18 sw/host: skrip host UART (host.py)
2026-10-19 target/asic: layout sky130 13 modul, makro SRAM untuk RAM/ROM bobot cnn_top, dan hasil
    [metrics.csv]
2026-10-19 graphify: graf repo diperbarui (termasuk target/ dan setup/) dan ikut di-commit
2026-10-21 target/kv260, sw/pynq: host AXI4-Lite (axil_ctrl.v) dan uji di papan; K-25..K-28
    - target/kv260: axil_ctrl.v, suaratb_axil_top.sv, template IP, block design, XDC,
    synth_axil.tcl, program_jtag.tcl, make_app.sh (opsi BITFILE); pin Pmod J2 dikoreksi
    - tb/sys/test_axil.py: uji cocotb (register, protokol, jarak sampel, dataset vs golden)
    - sw/pynq: driver PYNQ, axil_smoke/batch/mic, make_clips, calibrate_ambang, compare_results
    - model/pretrained: merge_tbs, teachers, split_exp, learning_curve
    - docs/vault/keputusan.md: K-25 sampai K-28 (TBscreen dan penambahan data tidak menaikkan AUROC)
    Batas klaim: jalur dataset terbukti di papan untuk 3 klip sintetis (logit = golden);
    mikrofon I2S belum te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
2026-10-21 target/kv260/axi: tambah axil_ctrl.sv (sumber bitstream yang diuji di papan)
    axil_ctrl.sv adalah versi SystemVerilog yang dipakai build Vivado axil_P32 dan bitstream yang
    terbukti di papan (jalur dataset: logit = golden untuk 3 klip sintetis). axil_ctrl.v adalah padanan
    Verilog-2001 yang lulus simulasi tetapi belum dibangun ulang di Vivado. Keduanya mendefinisikan
    modul axil_ctrl yang sama: jangan didaftarkan bersamaan ke alat. Skrip sintesis dan simulasi di
    repo memakai axil_ctrl.v.
2026-10-22 repo: abaikan graphify-out, hapus setup/
    graphify-out/ dimasukkan ke .gitignore dan dikeluarkan dari pelacakan git (berkas tetap ada di disk, dibangkitkan ulang oleh /graphify).
    setup/ (runbook WSL2 dan skrip lingkungan) dihapus; tidak ada kode yang merujuknya, isinya ada di riwayat git.
2026-10-22 target: kelompokkan kv260, pindah prep_synth ke common, hapus artix7 dan uart
    - kv260/ dibagi: axi/rtl (axil_ctrl.v, suaratb_axil_top.sv, template IP; legacy/axil_ctrl.sv sebagai arsip), axi/flow (sintesis, block design,
    XDC, make_app, program_jtag), analisis/ (sweep_estimasi).
    - prep_synth.py pindah ke target/common/ (dipakai semua alur sintesis); skrip sintesis Artix-7 (synth.tcl, run_sweep.sh) dihapus, ada di riwayat git.
    - target/kv260/uart (versi awal tanpa AXI) dihapus.
    - Makefile: target vivado dan clean-build dihapus (clean-build menghapus /data/suaratb/build lewat symlink target/build); jalur prep_synth diperbarui.
    - README target/ dan target/kv260/ ditulis ulang.
2026-10-22 rtl,tb,sw,target: hapus UART; AXI4-Lite satu-satunya host (K-34)
    Dihapus: rtl/sys (uart_rx, uart_tx, uart_bridge, csr, suaratb_top), uji UART (tb/sys/test_uart.py, test_top.py, tb/common/uart_model.py),
    sw/host (host UART), hasil layout ASIC uart_bridge. rtl/files.f tidak lagi memuat rtl/sys.
    Skrip Yosys dan sintesis sky130 menyintesis suaratb_axil_top. Pengganti: target/kv260/axi/rtl; uji ujung ke ujung tb/sys/test_axil.py
    (3 lulus, 1 dilewati). Tag submission tidak berubah.
    [metrics.csv]
2026-10-22 sw/pynq: papan, laptop, driver; banyak klip per peserta, fusi gejala, mode batuk, setup_papan
    - papan/: axil1, axil2 (dataset), mic1, mic2 (mikrofon), cough1, cough_mic (model batuk), fusi, setup_papan.sh; axil_smoke memuat aplikasi xmutil otomatis.
    - laptop/: make_clips (banyak klip per peserta), fit_fusi (fusi gejala + audio, ambang), calibrate_ambang.
    - driver/: driver PYNQ dan ujinya.
    - sw/bench dan sw/fusion (kosong) dan compare_results.py dihapus.
2026-10-22 docs: README, model.md bagian 9-10, keputusan K-29..K-34, sintesis, spesifikasi, status
    README diperbarui (papan KV260, hasil terukur, struktur repo). model.md: pengambilan sampel dan konfigurasi demo (bagian 9), model verifikasi
    batuk vs bukan batuk (bagian 10). keputusan.md: K-29..K-34. sintesis, spesifikasi, status-fase, result.md disesuaikan dengan penghapusan UART.
2026-10-22 docs: README, perintah menjalankan demo di papan (picocom, setup_papan, pindah paket dan model)
    Bagian baru di README root: konsol serial, pintasan setup_papan.sh, perintah model TBC dan model batuk, serta cara berpindah paket dan model. Pengecualian dari aturan dokumen tanpa perintah menjalankan, atas permintaan pengguna.
2026-10-22 docs: diagram arsitektur baru (jalur mikrofon I2S dan host AXI4-Lite)
    Mengganti docs/img/arsitektur.png dan teks alternatifnya di README; docs/img/README.md merujuk suaratb_axil_top.sv.
2026-10-22 docs: README, hapus tabel Artix-7 dari root, perintah papan kembali ke sudo python3
    Tabel sintesis Artix-7 dikeluarkan dari README root (ada di docs/vault/sintesis.md). Perintah menjalankan di papan memakai sudo python3 per paket; mematikan papan dan menyalin paket ke kartu SD tidak dicantumkan.
2026-10-22 docs: README, rapikan bahasa dan tambah bagian penggunaan AI
    Prosa README dirapikan (pembuka, hasil dan evaluasi, status, langkah di papan) tanpa mengubah angka, perintah, atau jalur. Bagian baru Penggunaan AI di bagian bawah.
2026-10-22 docs: README, jelaskan dua konfigurasi clock (10,24 MHz dan 300 MHz)
    300 MHz adalah clock tertinggi yang dibangun di KV260 dengan timing terpenuhi dan satu-satunya yang dijalankan di papan; 10,24 MHz adalah titik kerja untuk implementasi berikutnya (rasio BCLK 10:1, slack longgar, latensi CNN tetap dalam milidetik).
2026-10-22 target/asic: tulis ulang README dan tautkan paket hasil ke GitHub Release
    README menjelaskan fungsi tiap direktori, hasil cnn_top P16 10,24 MHz
    (kapasitansi, antena, LVS, routing DRC, signoff XOR/DRC = 0), keputusan desain,
    keterbatasan, dan rencana menuju tape-out. Paket hasil layout (774 MB) dirilis di
    Release asic-cnn-top-p16-10m24-v1 beserta checksum SHA-256; layout/README.md dan
    layout/metrics.csv menjelaskan isinya.
    [metrics.csv]
2026-10-22 target/asic: hasil cnn_top P16 10,24 MHz, skrip signoff dan ECO
    cnn_top P=16 pada 10,24 MHz (run p16_10m_eco8): kapasitansi, antena, LVS,
    routing DRC, dan signoff XOR/DRC tanpa makro semuanya 0; timing bersih di 9
    corner. GDS, DEF, netlist, dan SPEF dirilis di GitHub Release
    asic-cnn-top-p16-10m24-v1; di repo hanya metrik dan skrip.
    - results/cnn_top/: metrics.json final, timing_ringkas.txt,
    signoff_nomacro.json, riwayat_eco.csv (dasar sampai putaran 8).
    - scripts/layout_cnn_macro.py: diganti versi yang menghasilkan hasil final
    (FLOOR=2, FIX=1, SIGNOFF=ip); path disesuaikan ke scripts/.
    - scripts/signoff_nomacro.py: XOR dan DRC KLayout pada GDS tanpa makro.
    - scripts/cnn_top_eco/: run d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
    [riwayat_eco.csv]
2026-10-22 target/asic: hapus render PNG dan skrip render_layout.py
    Gambar layout (results/*.png) dan render_layout.py tidak dipakai lagi; hasil
    dirujuk lewat metrik dan Release. Rujukan di README dan collect_results.py
    dibersihkan.
2026-10-22 docs/result: perbarui laporan hasil sampai 23 Oktober 2026
    result.md ditulis ulang dan report.pdf dibangun ulang (13 halaman, sampul, daftar isi).
    Menambahkan hasil sejak 12 Oktober: sintesis dan uji papan KV260 (bit-exact 968/968 klip),
    percobaan penguatan audio dan model gejala (K-25 sampai K-33), model demonstrasi batuk vs
    bukan batuk (K-29), UART dihapus (K-34), dan bagian baru layout ASIC sky130 (cnn_top P16
    10,24 MHz dengan kapasitansi, antena, LVS, DRC routing, dan signoff XOR/DRC = 0).
    Klaim "jalan di papan" diperbarui sesuai bukti uji papan.
2026-10-24 sw/pynq: hapus direktori laptop
    Menghapus calibrate_ambang.py, fit_fusi.py, make_clips.py, dan __init__.py dari sw/pynq/laptop.
    Skrip tetap tersedia di riwayat git (commit sebelum ini).
